udawat/Explore-Labs-ESP8266-WiFi-Internet-of-Things-IoT-Breakout/README.md

# Explore-Labs-ESP8266-WiFi-Internet-of-Things-IoT-Breakout
It is based on the widely popular ESP8266EX SoC from Espressif. It is breadboard friendly, supports input voltage from 3.3V to 5V and its level-shifted Tx, Rx pins are 5V compatible.
