udawat/Explore-Labs-ESP8266-WiFi-Internet-of-Things-IoT-Breakout/Explore Labs ESP8266 WiFi Internet of Things IoT Breakout.pdf

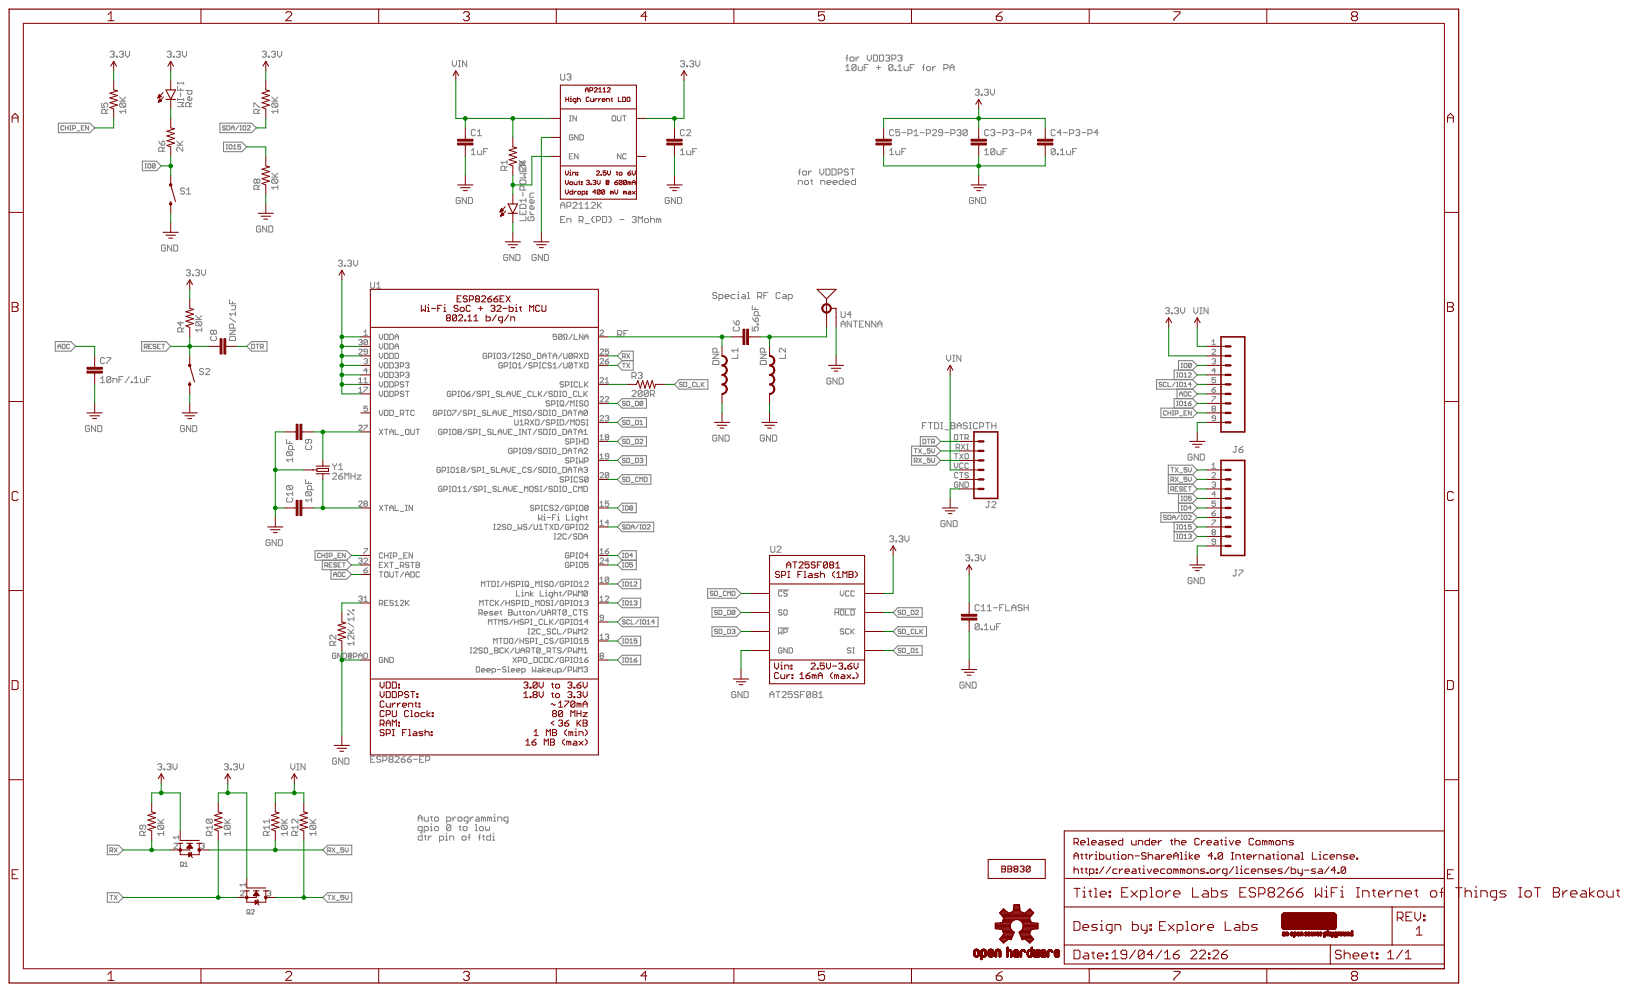
[picture p1: page 1]
