udawat/Explore-Labs-ESP8266-WiFi-Internet-of-Things-IoT-Breakout/Explore Labs ESP8266 WiFi Internet of Things IoT Breakout.brd

## EAGLE design Explore Labs ESP8266 WiFi Internet of Things IoT Breakout.brd (2016-04-19)

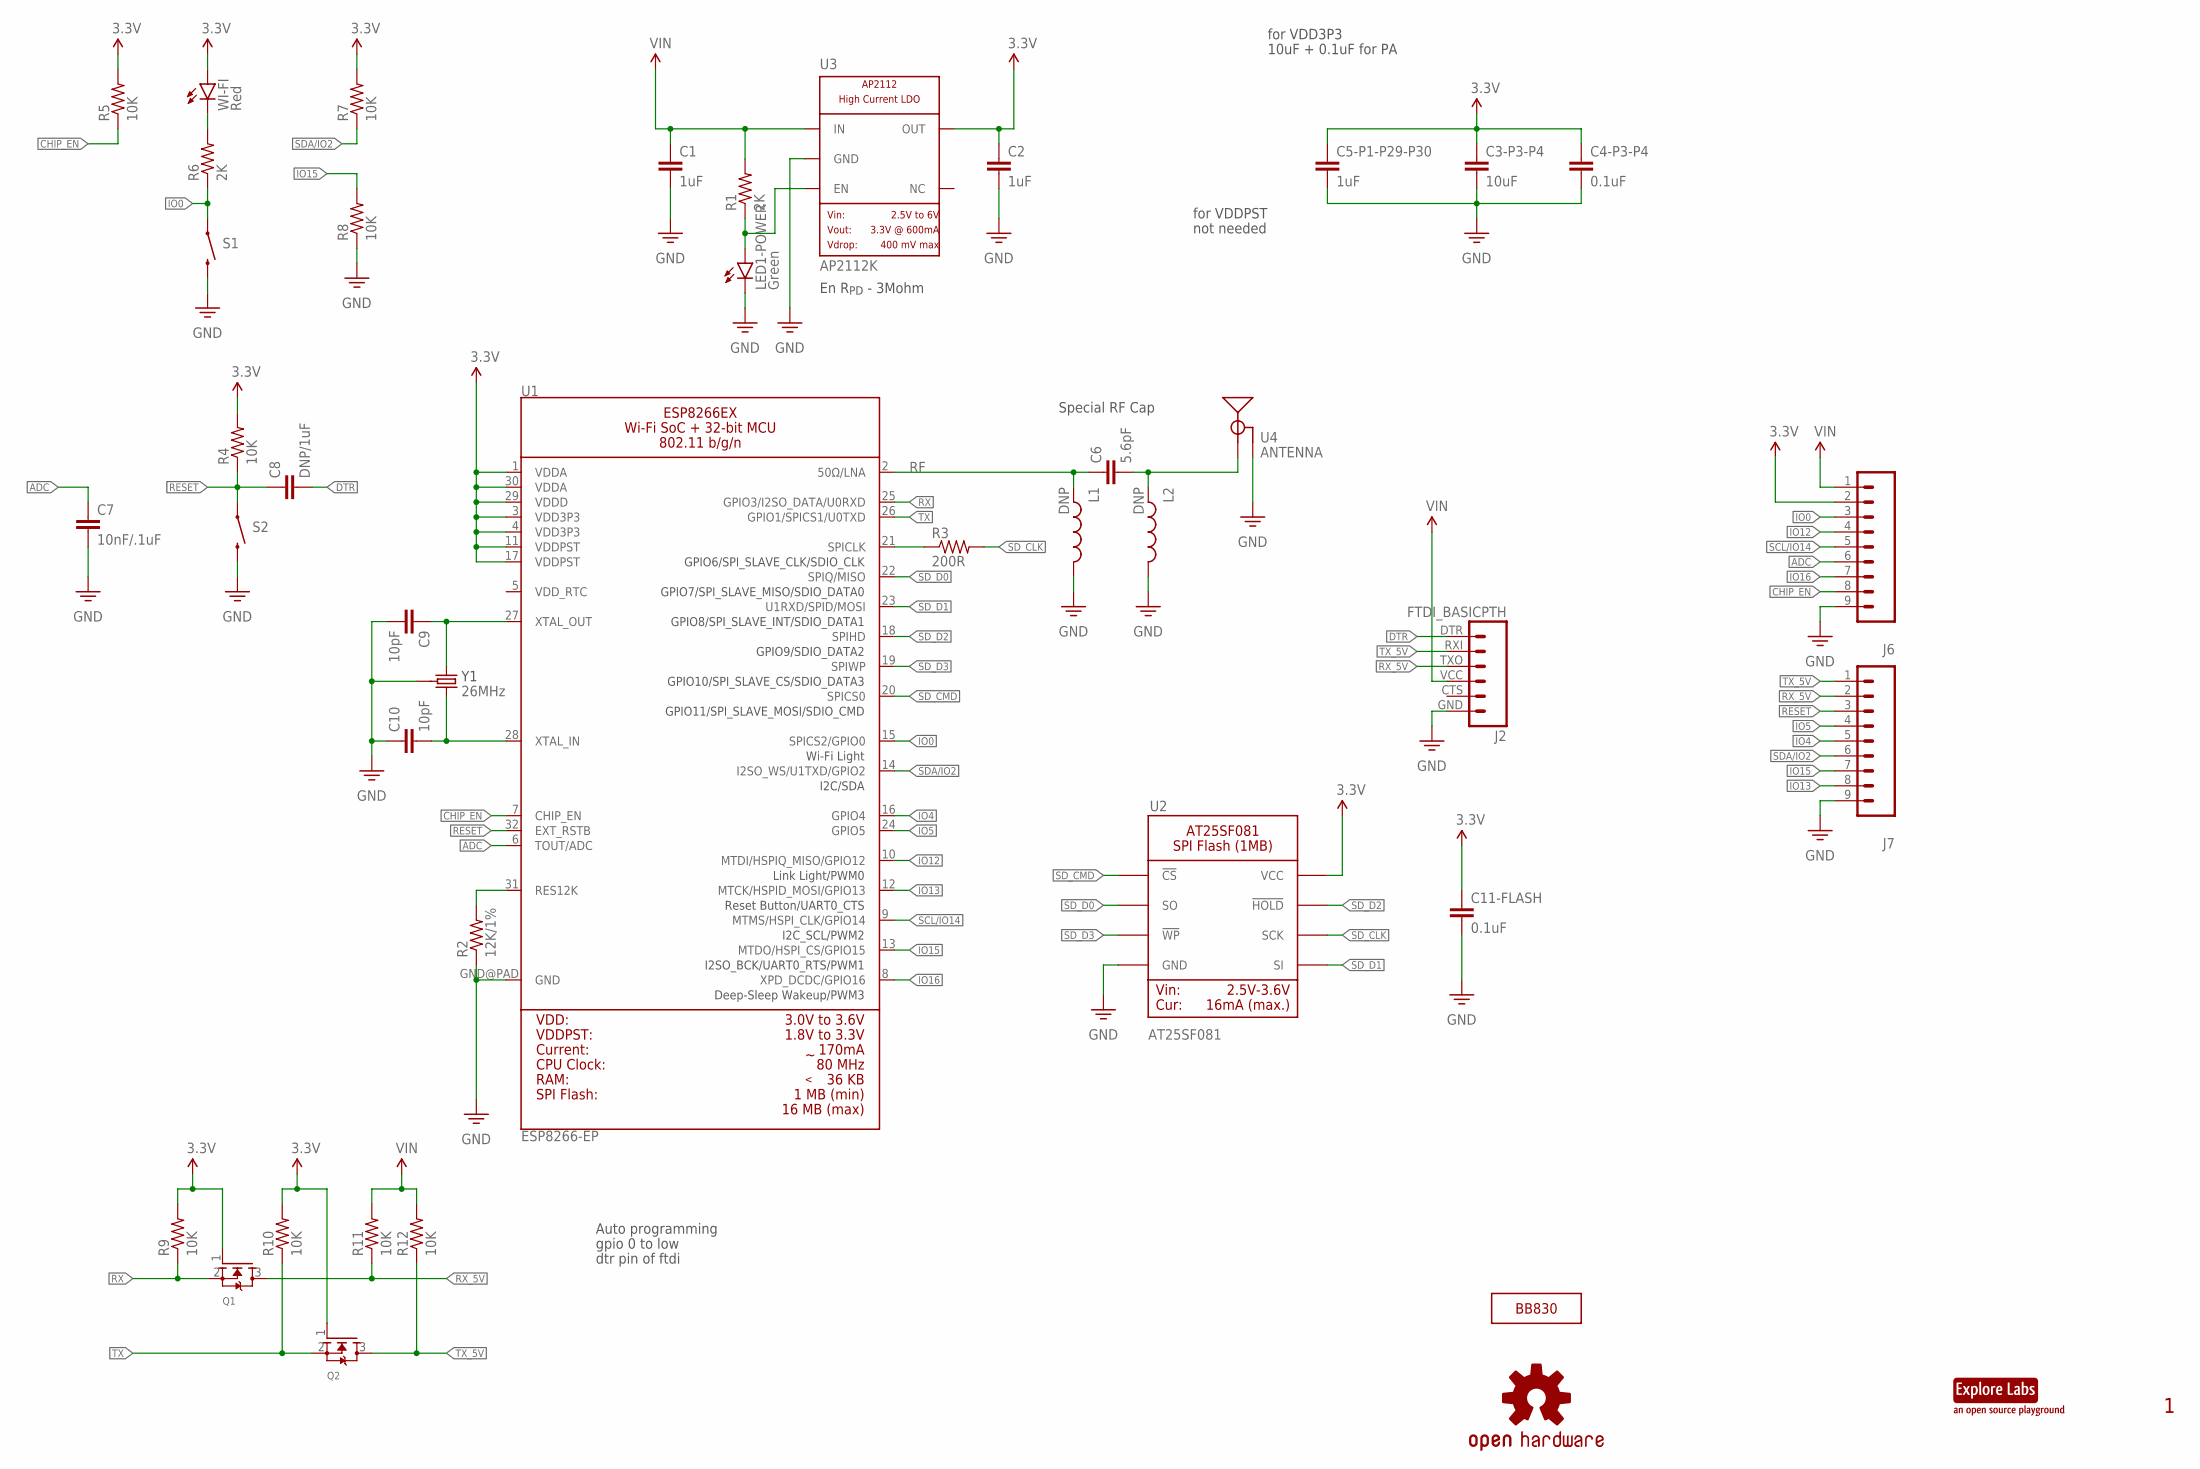
[picture p2: schematic Explore Labs ESP8266 WiFi Internet of Things IoT Breakout.sch]

Parts:
C1, C2, C5-P1-P29-P30: 1uF; 0402-CAP
C3-P3-P4: 10uF; 0603-CAP
C4-P3-P4, C11-FLASH: 0.1uF; 0402-CAP
C6: 5.6pF; 0402-CAP
C7: 10nF/.1uF; 0402-CAP
C8: DNP/1uF; 0402-CAP
C9, C10: 10pF; 0402-CAP
J2: FTDI_BASICPTH; FTDI_BASIC
J6, J7: M09; 1X09
L1, L2: DNP; 0402-FERRITE
LED1-POWER: Green; LED-0603
LOGO1: OSHW-LOGOBOTTOM; OSHW-LOGO-M-BOTTOM
Q1, Q2: MOSFET-N; SOT23
R1, R6: 2K; 0402-RES
R2: 12K/1%; 0402-RES
R3: 200R; 0402-RES
R4, R5, R7, R8, R9, R10, R11, R12: 10K; 0402-RES
S1, S2: SWITCH-NO-MOM; KXT-SWITCH
U1: ESP8266-EP; QFN32
U2: AT25SF081; SO08
U3: AP2112K; SOT23-LDO
U4: ANTENNA; ANTENNA-WROOM-02-INV
U$3: 26MHz; CRYSTAL-3225
U$4: EXPLORE-LABS-LOGOBOTTOM; EXLABS_LOGO_0.25
U$7: BREADBOARD-830
WI-FI: Red; LED-0603

Connections:
3.3V: C2.1, C3-P3-P4.1, C4-P3-P4.1, C5-P1-P29-P30.1, C11-FLASH.1, J6.2, Q1.1 (G), Q2.1 (G), R4.2, R5.2, R7.2, R9.2, R10.2, U1.1 (VDDA), U1.3 (VDD3P3), U1.4 (VDD3P3), U1.11 (VDDPST), U1.17 (VDDPST), U1.29 (VDDD), U1.30 (VDDA), U2.8 (VCC), U3.5 (OUT), WI-FI.A
ADC: C7.1, J6.6, U1.6 (TOUT/ADC)
CHIP_EN: J6.8, R5.1, U1.7 (CHIP_EN)
DTR: C8.2, J2.DTR (1)
GND: C1.2, C2.2, C3-P3-P4.2, C4-P3-P4.2, C5-P1-P29-P30.2, C7.2, C9.2, C10.1, C11-FLASH.2, J2.GND (6), J6.9, J7.9, L1.2, L2.2, LED1-POWER.C, R2.1, R8.1, S1.2, S2.2, U1.GND@PAD (GND), U2.4 (GND), U3.2 (GND), U4.GND, U$3.2 (3), U$3.4 (3)
IO0: J6.3, R6.1, S1.1, U1.15 (SPICS2/GPIO0)
IO4: J7.5, U1.16 (GPIO4)
IO5: J7.4, U1.24 (GPIO5)
IO12: J6.4, U1.10 (MTDI/HSPIQ_MISO/GPIO12)
IO13: J7.8, U1.12 (MTCK/HSPID_MOSI/GPIO13)
IO15: J7.7, R8.2, U1.13 (MTDO/HSPI_CS/GPIO15)
IO16: J6.7, U1.8 (XPD_DCDC/GPIO16)
unnamed: R3.1, U1.21 (SPICLK)
unnamed: R6.2, WI-FI.C
unnamed: LED1-POWER.A, R1.1, U3.3 (EN)
unnamed: C9.1, U1.27 (XTAL_OUT), U$3.1
unnamed: C10.2, U1.28 (XTAL_IN), U$3.3 (2)
unnamed: R2.2, U1.31 (RES12K)
unnamed: C6.2, L2.1, U4.SIG (SIGNAL)
RESET: C8.1, J7.3, R4.1, S2.1, U1.32 (EXT_RSTB)
RF: C6.1, L1.1, U1.2 (50Ω/LNA)
RX: Q1.2 (S), R9.1, U1.25 (GPIO3/I2SO_DATA/U0RXD)
RX_5V: J2.TXO (3), J7.2, Q1.3 (D), R11.1
SCL/IO14: J6.5, U1.9 (MTMS/HSPI_CLK/GPIO14)
SDA/IO2: J7.6, R7.1, U1.14 (I2SO_WS/U1TXD/GPIO2)
SD_CLK: R3.2, U2.6 (SCK)
SD_CMD: U1.20 (SPICS0), U2.1 (!CS)
SD_D0: U1.22 (SPIQ/MISO), U2.2 (SO)
SD_D1: U1.23 (U1RXD/SPID/MOSI), U2.5 (SI)
SD_D2: U1.18 (SPIHD), U2.7 (!HOLD)
SD_D3: U1.19 (SPIWP), U2.3 (!WP)
TX: Q2.2 (S), R10.1, U1.26 (GPIO1/SPICS1/U0TXD)
TX_5V: J2.RXI (2), J7.1, Q2.3 (D), R12.1
VIN: C1.1, J2.VCC (4), J6.1, R1.2, R11.2, R12.2, U3.1 (IN)

Notes on the sheet:
Auto programming
gpio 0 to low
dtr pin of ftdi
for VDD3P3
10uF + 0.1uF for PA
Special RF Cap
for VDDPST
not needed
En R_{PD} - 3Mohm

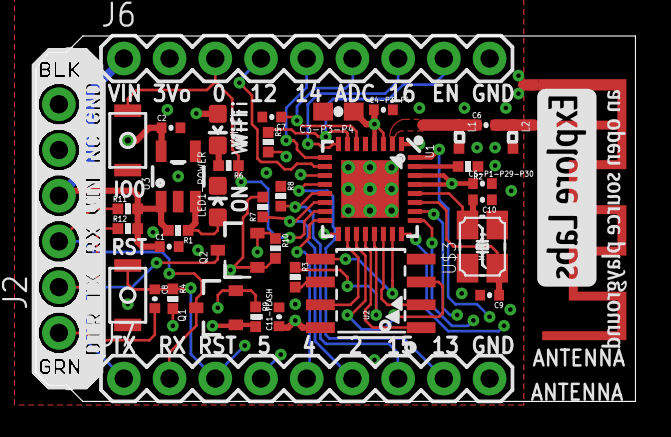
[picture p3: board Explore Labs ESP8266 WiFi Internet of Things IoT Breakout.brd from above]

Board: 4 copper layers, 33.3 x 20.3 mm, 44 parts (1 on the bottom side), 34 nets.

Other parts of the board:
U$1: ESP-FTDI-BOTTOM
U$2: ESP-FTDI
