udawat/Explore-Labs-ESP8266-WiFi-Internet-of-Things-IoT-Breakout/(notices)

Notices in the files:
parts and their libraries:
SparkFun-LED: Licensing: Creative Commons ShareAlike 4.0 International - https://creativecommons.org/licenses/by-sa/4.0
Explore Labs EAGLE Library: Released under the Creative Commons
Explore Labs EAGLE Library: http://creativecommons.org/licenses/by-sa/4.0
